jasonlin316/RISC-V-CPU/pic/block_diagram_black.png

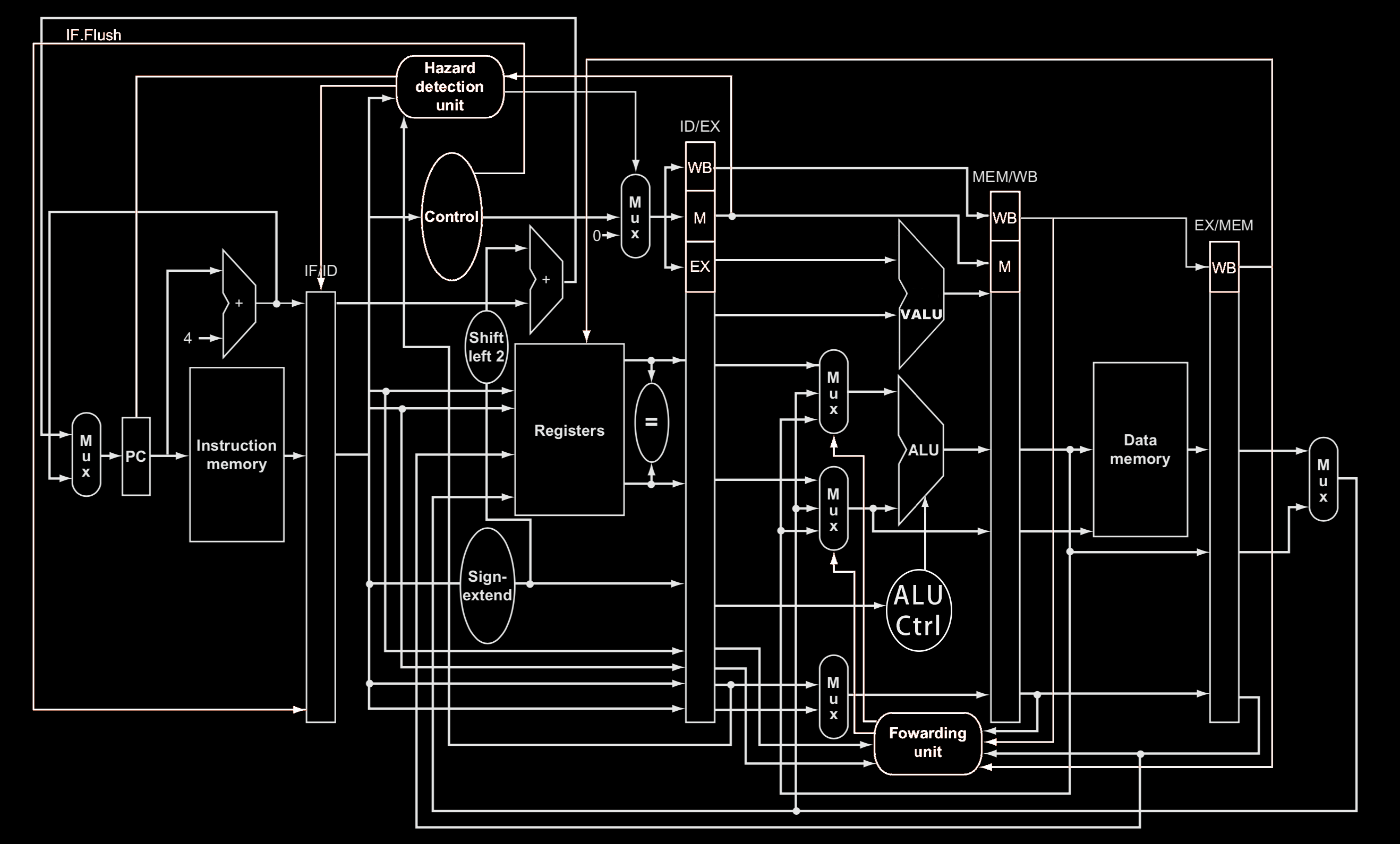
pic/block_diagram_black.png
