jasonlin316/RISC-V-CPU/pic/program_counter.png

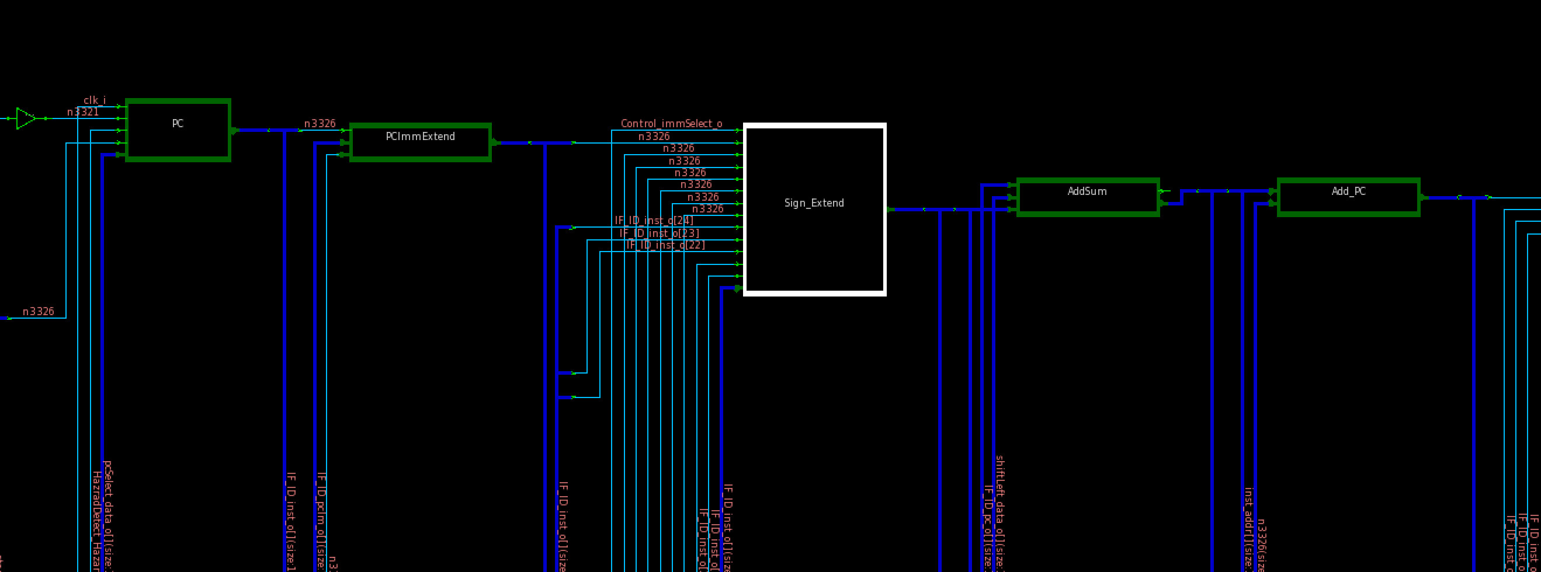
pic/program_counter.png
