jasonlin316/RISC-V-CPU/pic/HazardDetect.png

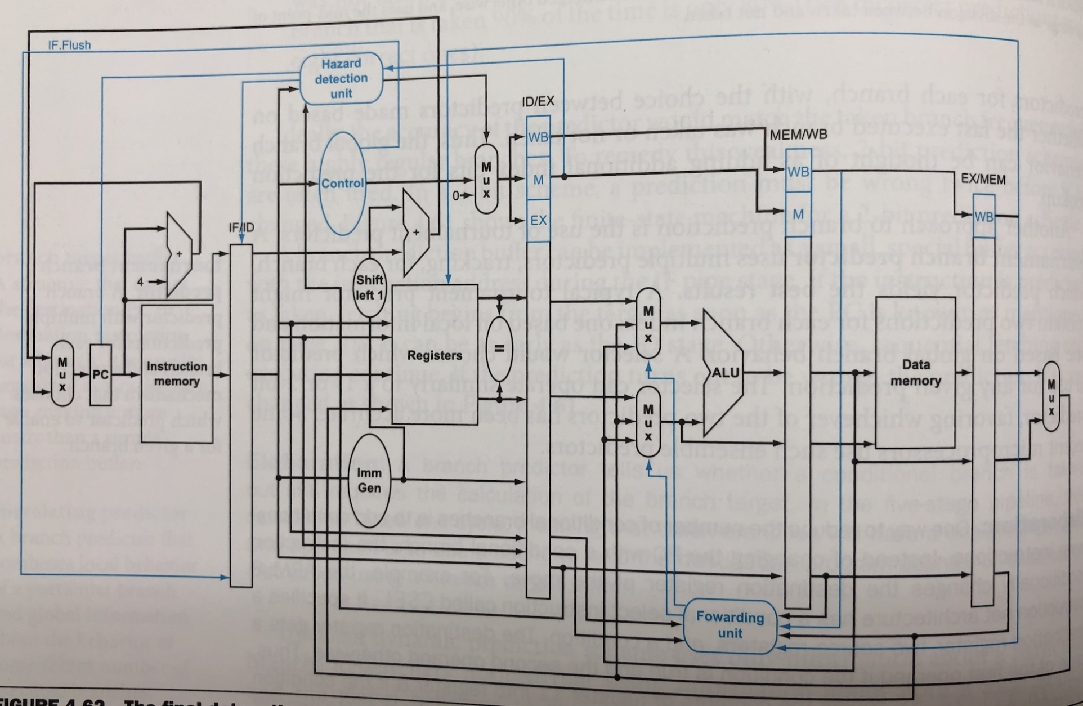
pic/HazardDetect.png
