jasonlin316/RISC-V-CPU/(commit log)

2019-05-16 Updates to fix bug of instruction memory
    [CPU.v, Instruction_Memory.v, testbench.v]
2019-05-16 Update2 to fix bug of instruction memory
    [CPU.v, Instruction_Memory.v, testbench.v]
